RavinduHiroshan/MR_ROBOT/Mr.Robot.pdf

## MR. ROBOT

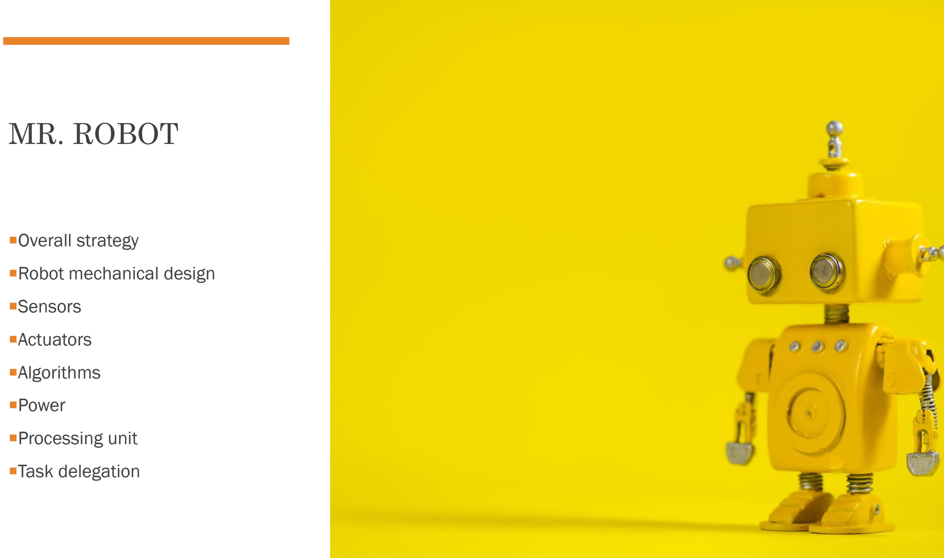
[picture p15: page 1]

Overall strategy

Robot mechanical design

Sensors

Actuators

Algorithms

Power

Processing unit

Task delegation

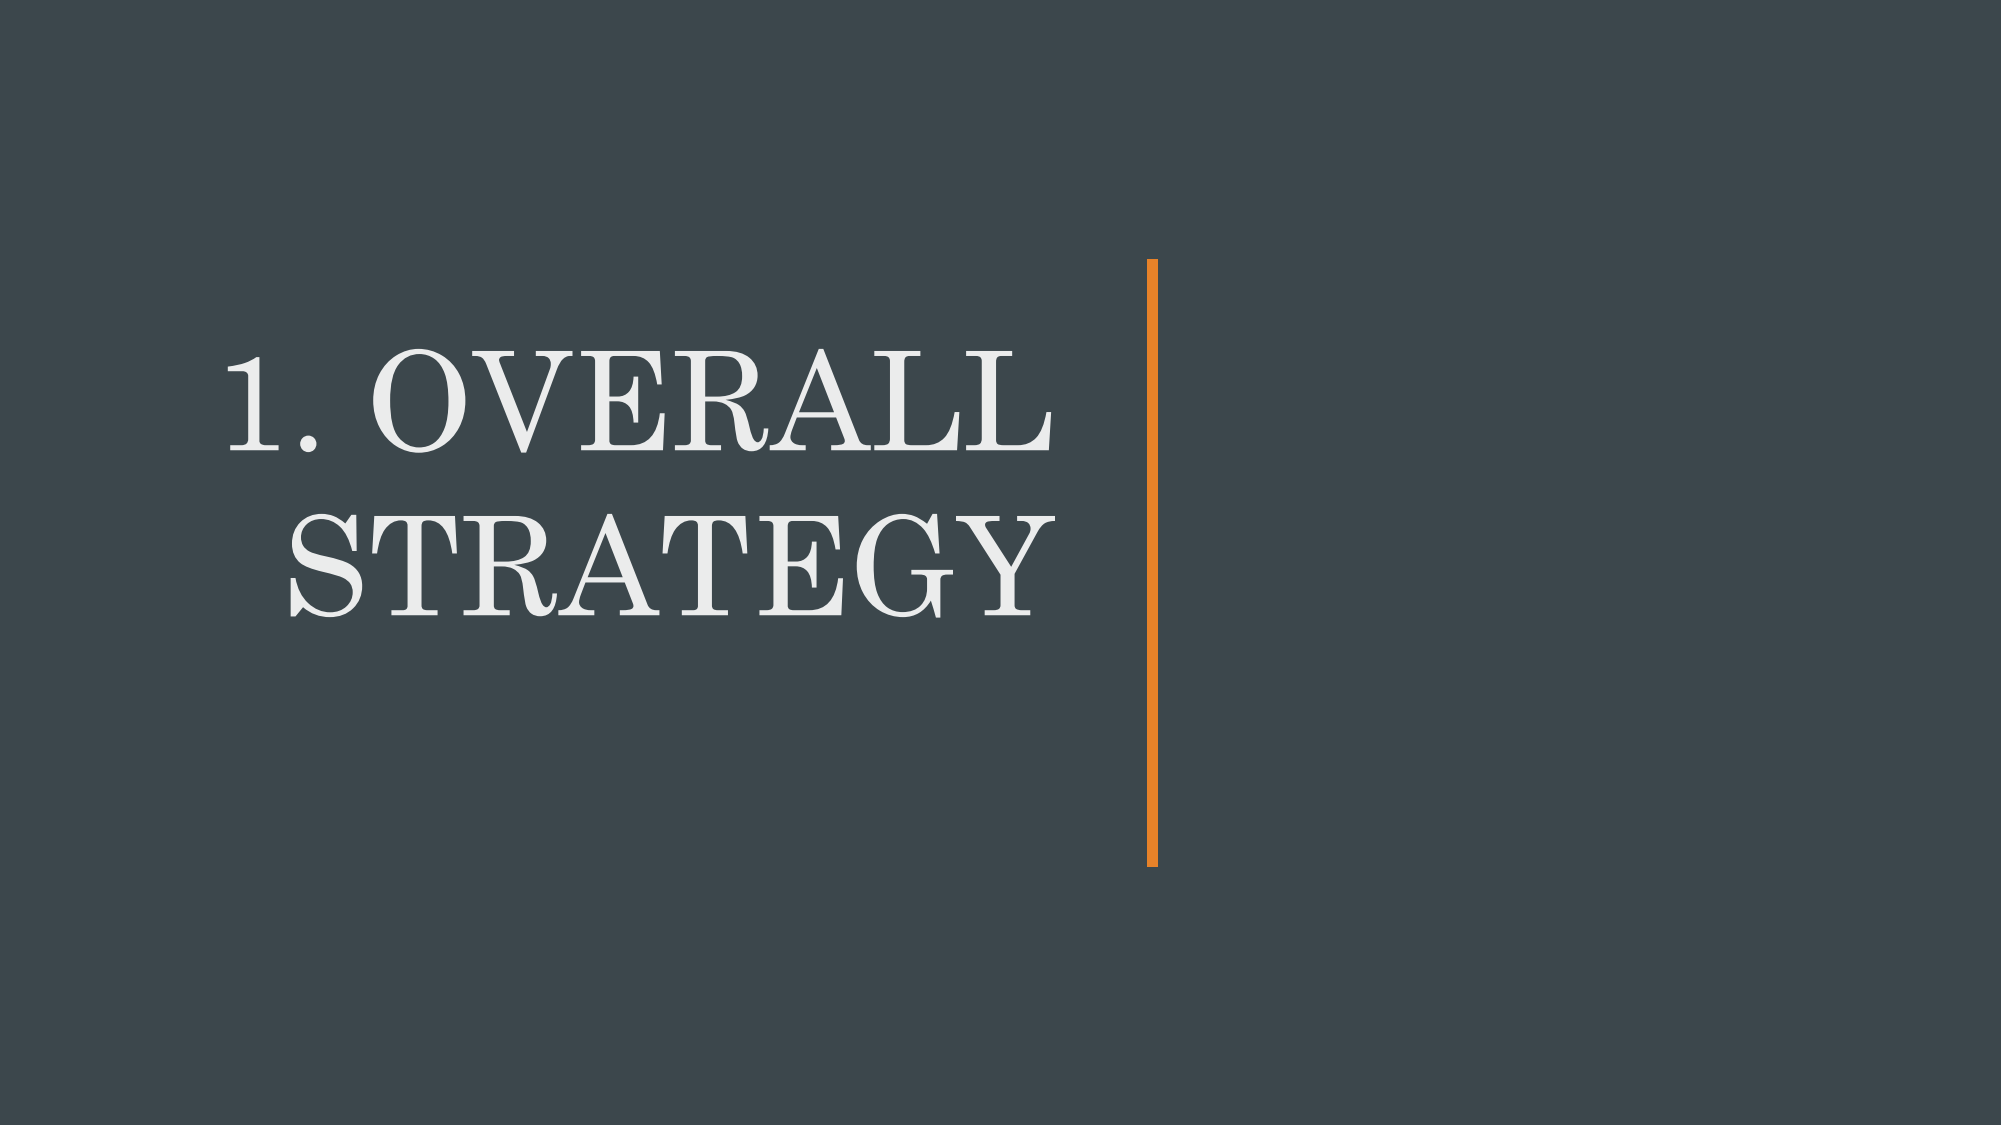
[picture p16: page 2]

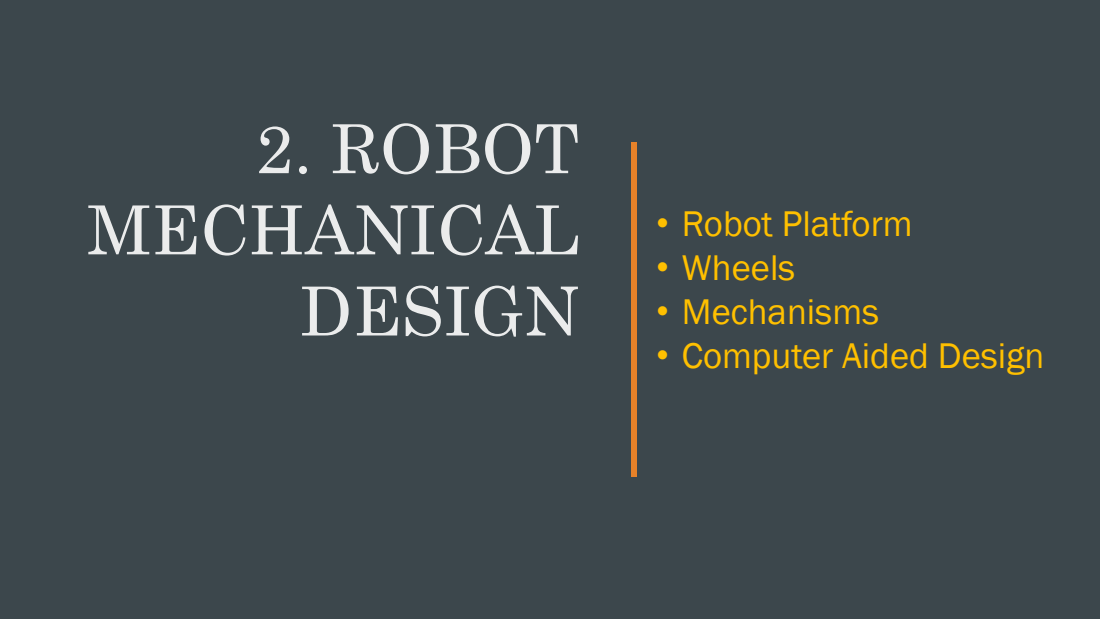
[picture p17: page 3]

• Robot Platform
• Wheels
• Mechanisms
• Computer Aided Design

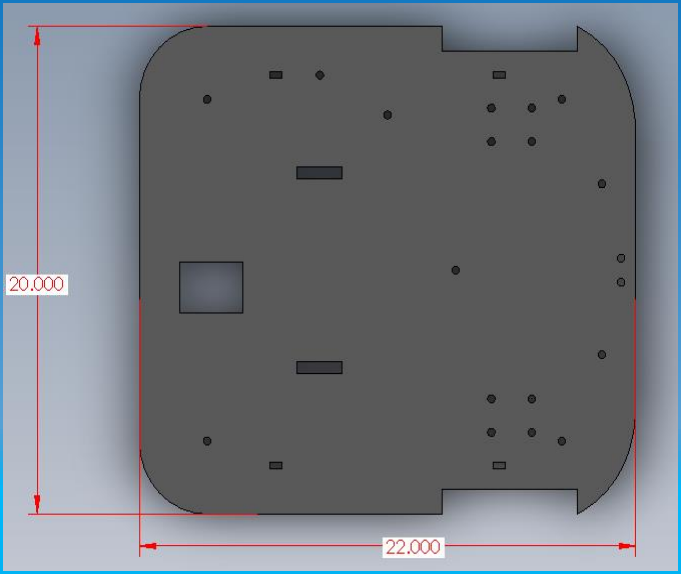
[picture p18: figure]

# BLUEPRINT

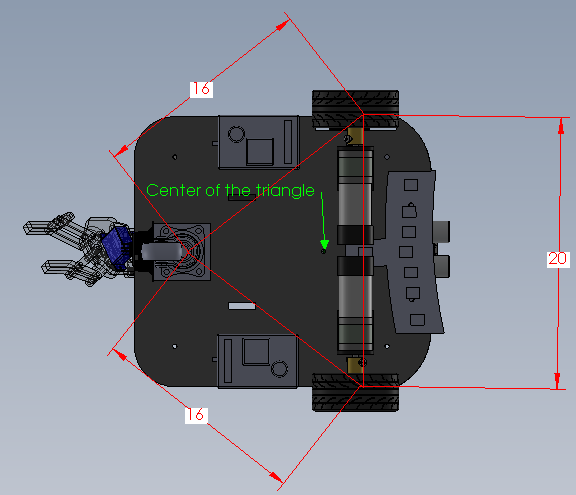
[picture p19: figure]

# SUPPORT POLYGON & WHEELS

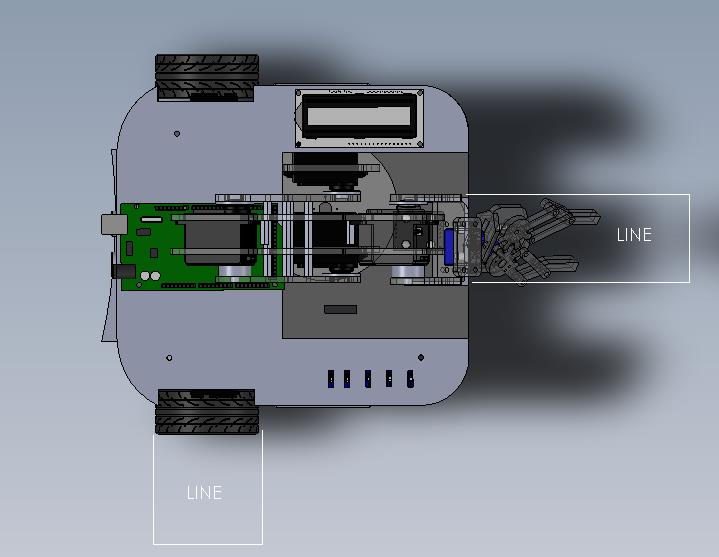
[picture p20: figure]

# DRIVE MECHANISM

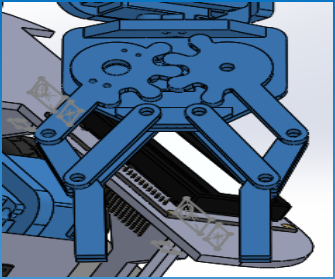
[picture p21: figure]

# ARM MECHANISM

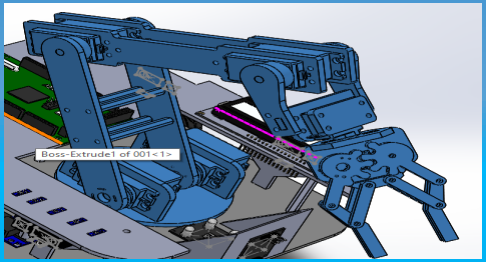
[picture p22: figure]

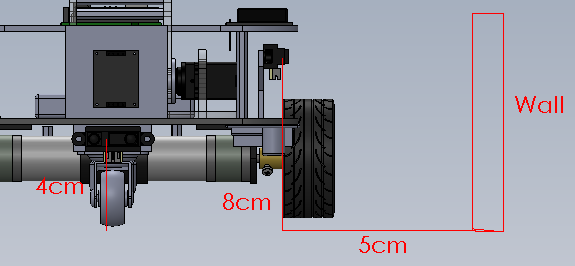
[picture p23: figure]

# SENSOR

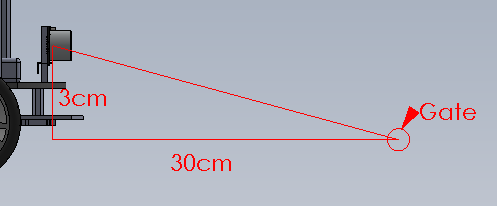
[picture p24: figure]

# PLACEMENT

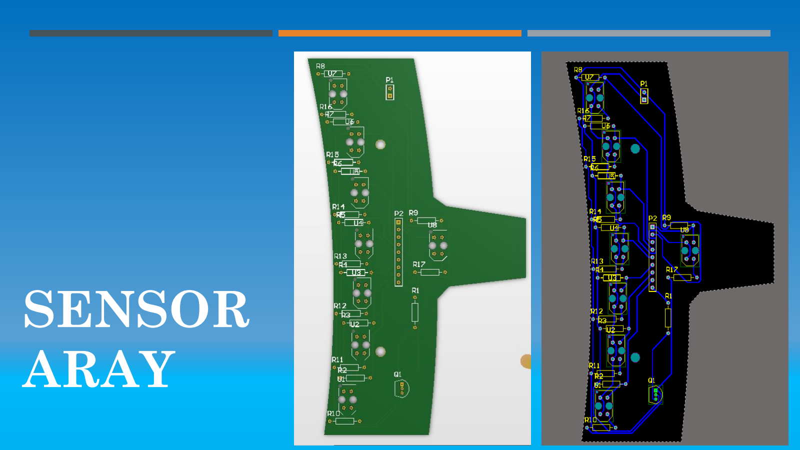
[picture p25: page 9]

# SENSOR ARAY

# COMPUTER AIDED DESIGN

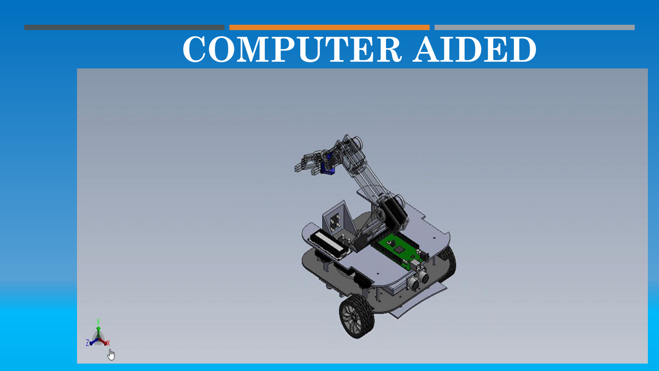
[picture p26: page 10]
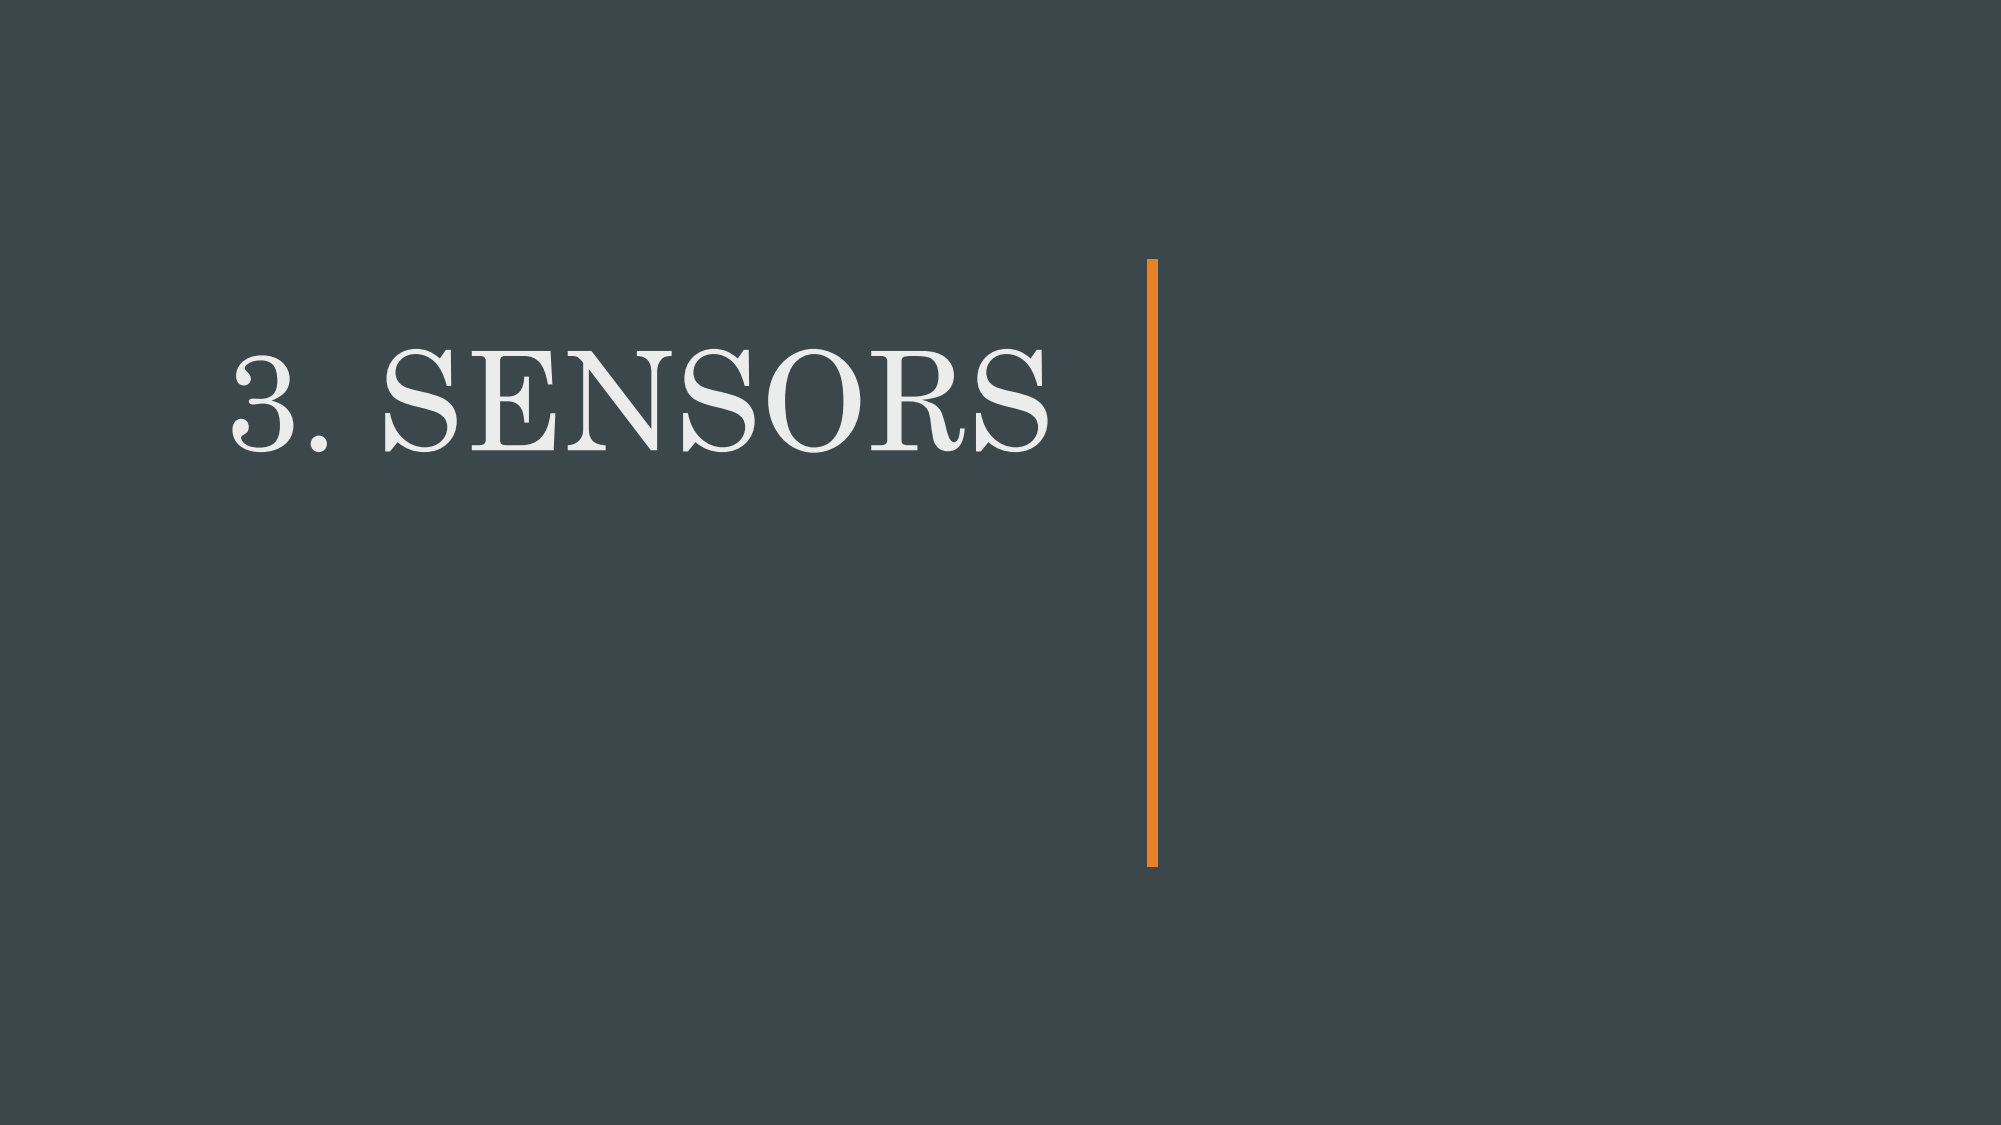
[picture p27: page 11]

# Sharp IR

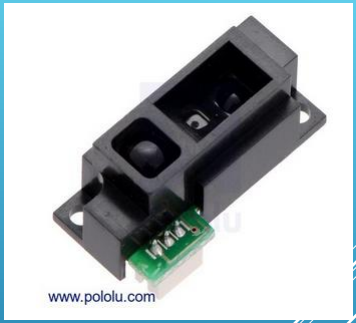
[picture p28: figure]

Name – GP2Y0A51
Detect range – 2cm to 15cm
Number of sensors we use – 5 sensors (GP2Y0A51) Located on- Left side 2, Right side 2 and Back side 1

we use the sharp IRs for
- Wall Following
- Pillars detecting
- Color box detecting

Why should we use that sharp IR GP2Y0A51?
- Wall is curve therefore difficult to identify using Ultrasonic sensors
- Wall and the pillars are 15cm away from the white line

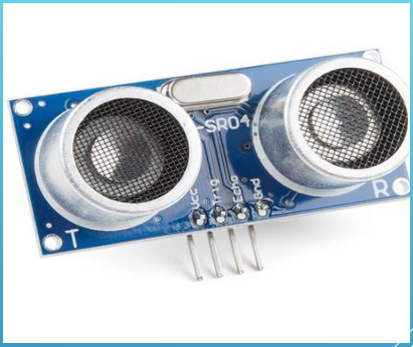
[picture p29: figure]

## Ultrasonic Sensor

Name – HC-SR04
In practically measuring distance range – 2cm to 80cm Measuring angle covered – 15 degrees covered Number of sensors we use – only one sensor
Located on – front side of the robot

## we use the ultrasonic sensor for

- We use to detect the synchronous gate

## Why should we use ultrasonic?

- It has 15 degrees measuring angle covered
- Gate is a moving object therefore we need a wider range sensor
- Before the gate we have a holding position. From holding position to gate has 30cm-40cm distance approximately

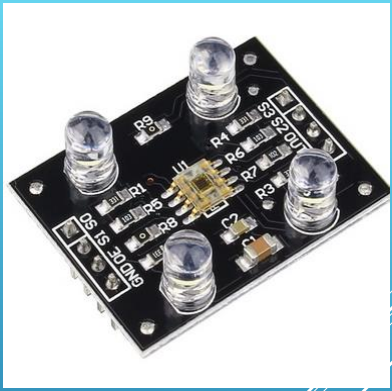
[picture p30: figure]

# Color sensor

Name – TCS230
8x8 photo diode array
Using current to frequency converter
Light measurements should be made at about 1~3cm to get a more accurate result.

Number of sensors we use – 2 sensors
Located on – design a special box for put the color box

Why should we use TCS230 sensors?
- In our task has 3 colors( red, blue, green)
- This sensor module can easy to identify red, blue and green
- frequency directly proportional to the light intensity
- Avarage cost

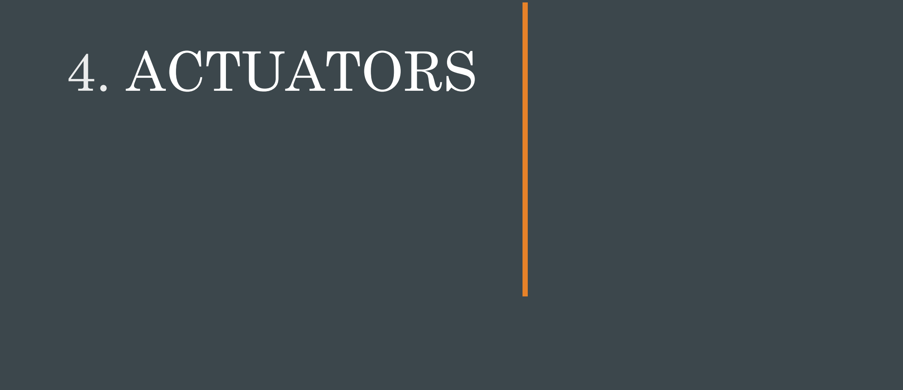
[picture p31: figure]
ACTUATORS

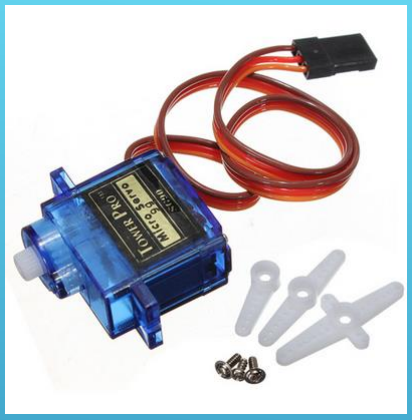
[picture p32: figure]

## Servo Motors

Name – MG90 and SG90
Number of servos – 6 servors ( 2 SG90 and 4 MG90 ) Using PWM system
| MG90 | SG90
Operating Voltage | 4.8V- 6V | 4.8V- 6V
Rotate | 180 degrees | 180 degrees
torque | 2.2 Kg/cm | 2.5Kg/cm
Gear type | Metal | Plastic

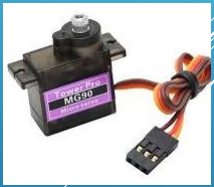
[picture p33: figure]

## Why should we use servo motors?

## 34:1 12V High Power DC Motor

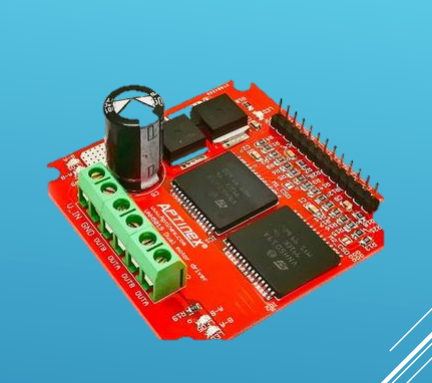
[picture p34: figure]
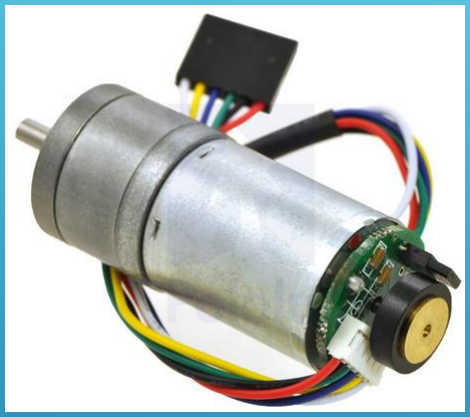
[picture p35: figure]

High Power Motor needs 5.6A stall current

We selected special motor drive
Dagaya 1.0
Maximum current -12A
Number of drives -2

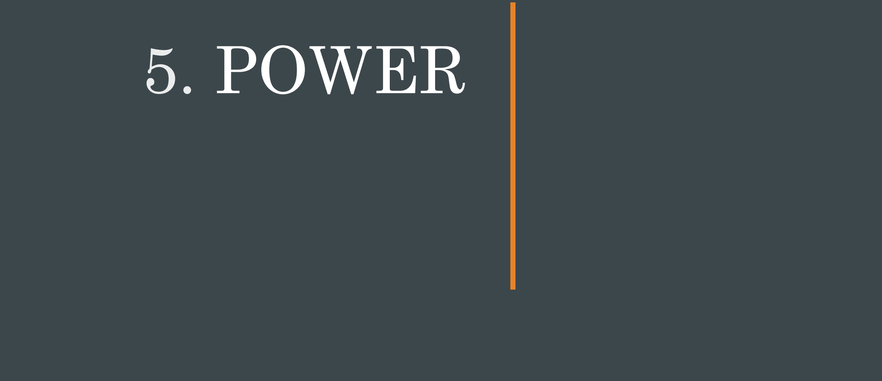
[picture p36: figure]
POWER

# Power System

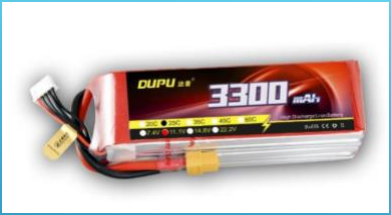
[picture p37: figure]

Name – Lithium Polymer Rechargeable battery 3300mAh
25C

## Why we use ?

We need – nearly 3000mA (maximum) Required discharge rate – 6C

# POWER

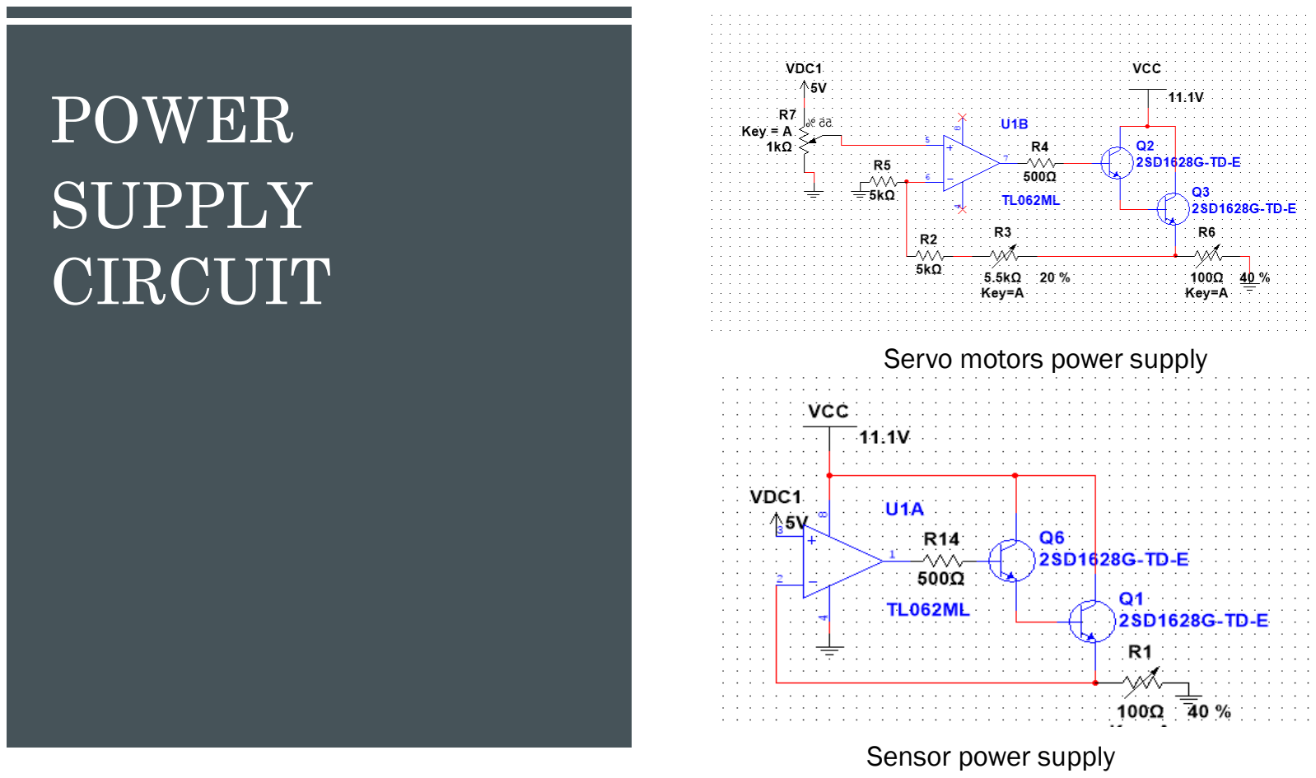
[picture p38: page 20]

# SUPPLY CIRCUIT

Sensor power supply

Servo motors power supply

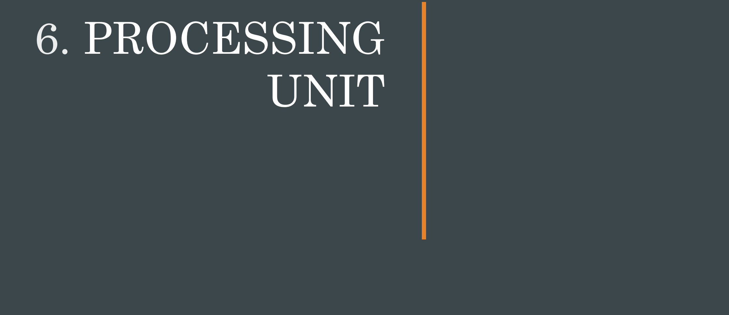
[picture p39: figure]
PROCESSING UNIT

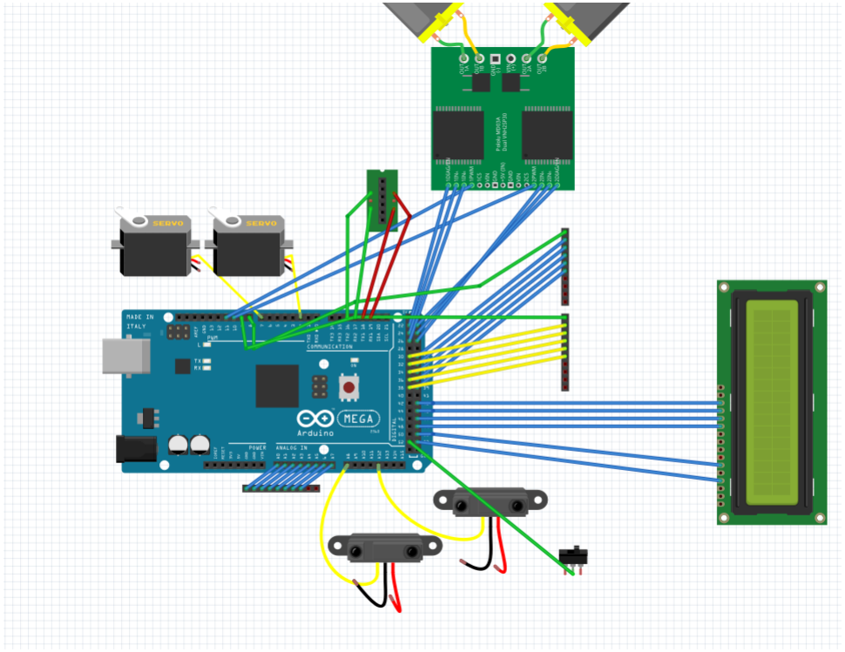
[picture p40: figure]

### - Arduino Mega 2560

### Board Is used as

### processing unit

### - Image shows wire

### configuration of the

### Arduino borard

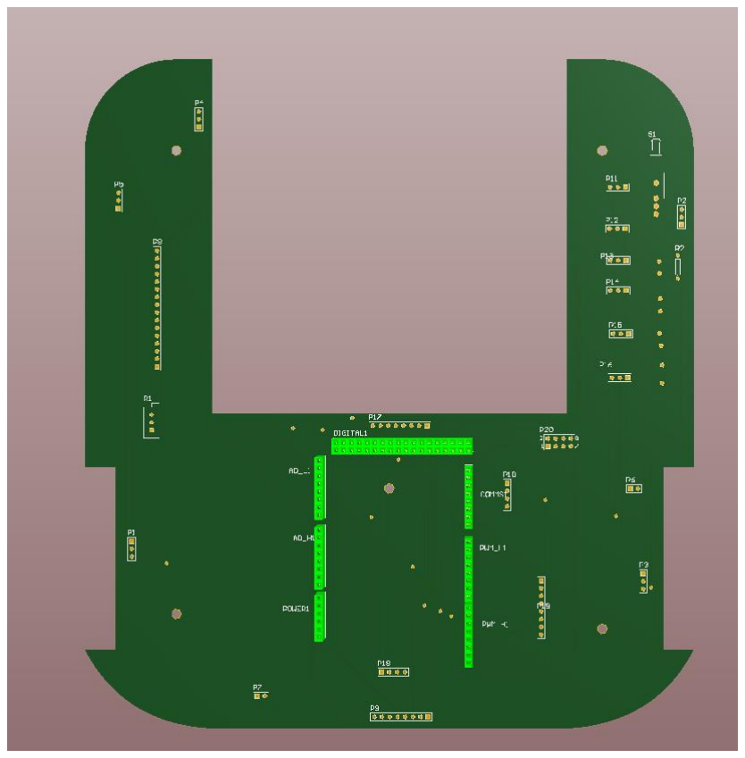
[picture p41: figure]

# PCB DESIGNS

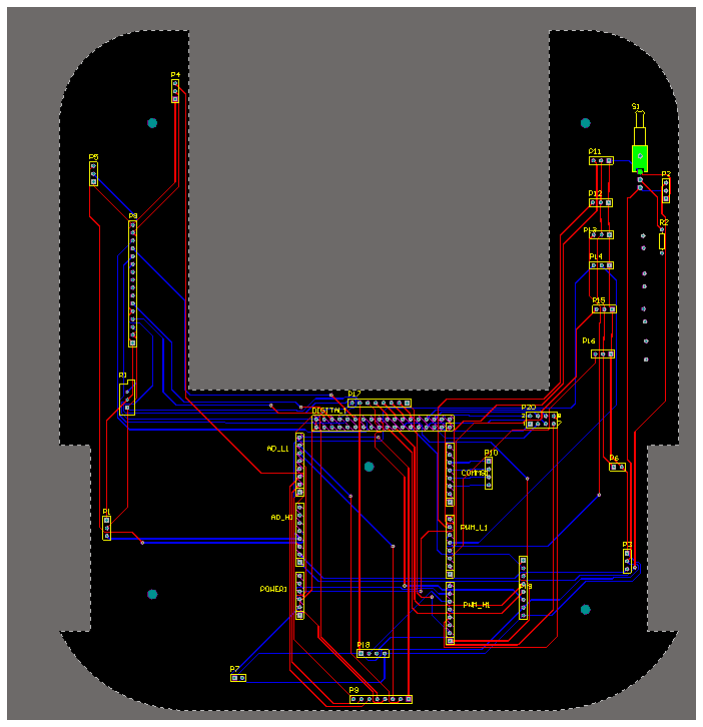
[picture p42: figure]
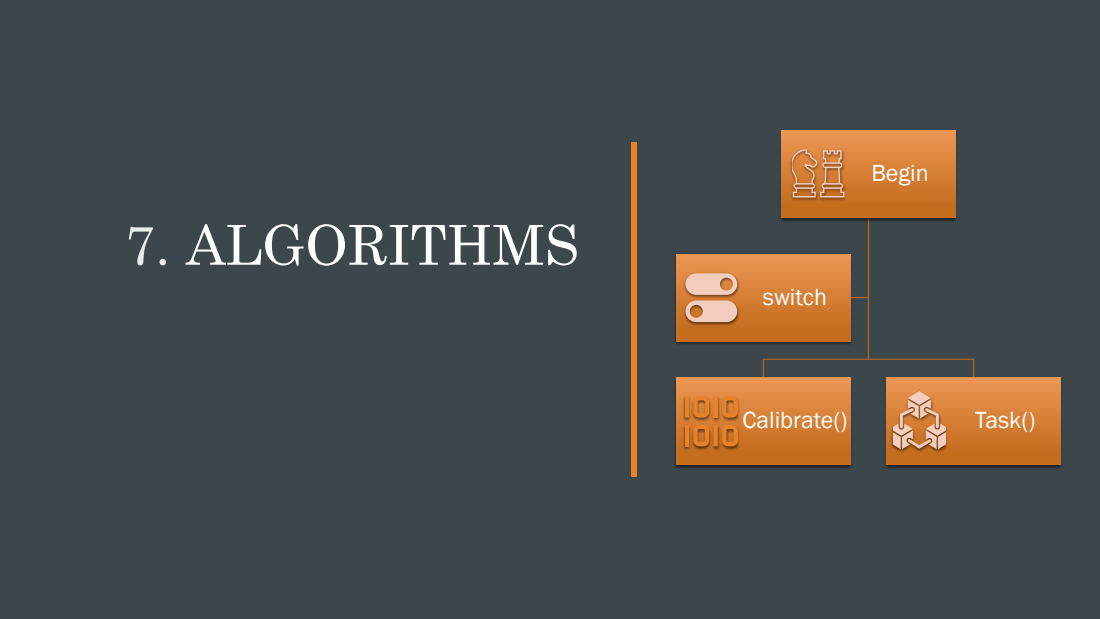
[picture p43: page 24]
ALGORITHMS; Begin; Calibrate(); Task(); switch

# Stages

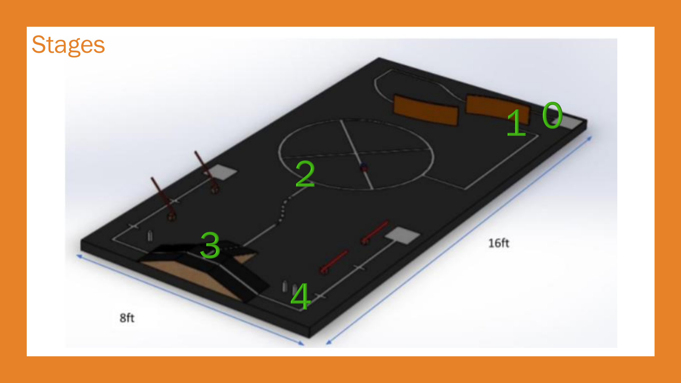
[picture p44: page 25]

### Calibrate()

1. Get maximum values of each sensors

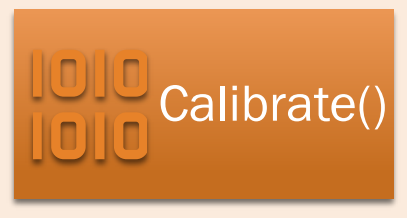
[picture p45: figure]
Calibrate()

2. Get minimum values of each sensors
3. Calculate average maximum
4. Calculate average minimum
5. Th (Thresher hold) = (average maximum + average minimum)/2
6. Return Th

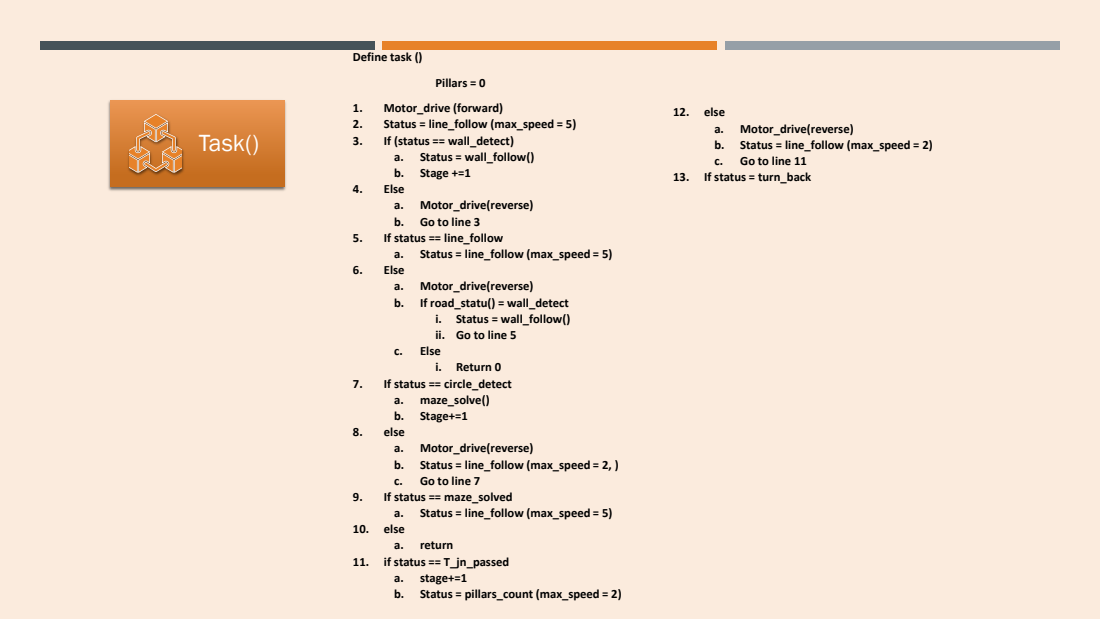
[picture p46: page 27]
Define task (); Pillars = 0; 1. Motor_drive (forward) 2. Status = line_follow (max_speed = 5) 3. If (status == wall_detect) a. Status = wall_follow() b. Stage +=1 4. Else; 5. If status == line_follow a. Status = line_follow (max_speed = 5) 6. Else a. Motor_drive(reverse) b. If road_statu() = wall_detect; c. Else i. Return 0 7. If status == circle_detect a. maze_solve() b. Stage+=1 8. else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

a. Motor_drive(reverse)
b. Status = line_follow (max_speed = 2)
c. Go to line 11

b. Go to line 3

i. Status = wall_follow()
ii. Go to line 5

b. Status = line_follow (max_speed = 2, )
c. Go to line 7

# SUB ALGORITHMS

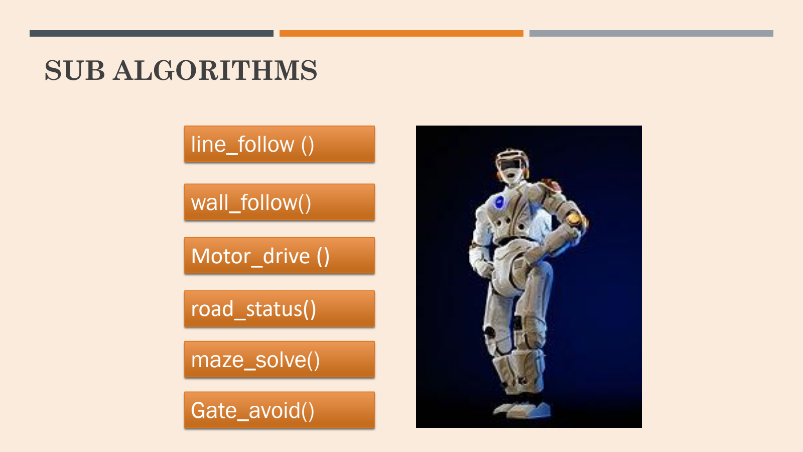
[picture p47: page 28]

## Motor_drive ()

## road_status()

## Gate_avoid()

## wall_follow()

## maze_solve()

## line_follow ()

# Sub Task

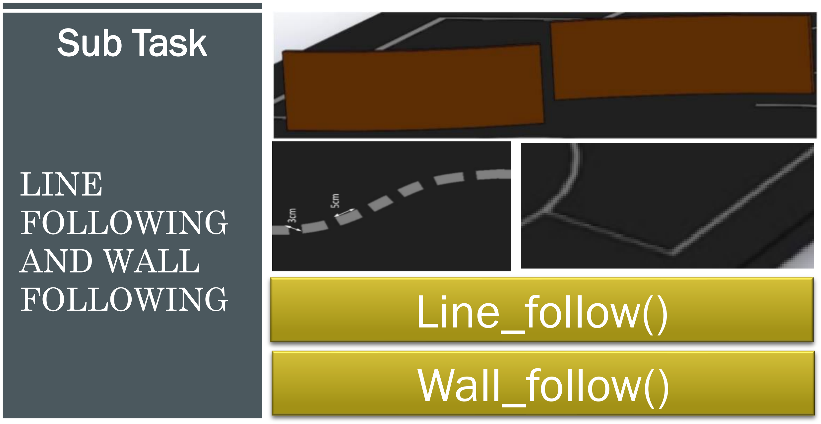
[picture p48: page 29]

# LINE FOLLOWING AND WALL

FOLLOWING | Line_follow()
| Wall_follow()

# Sub Task

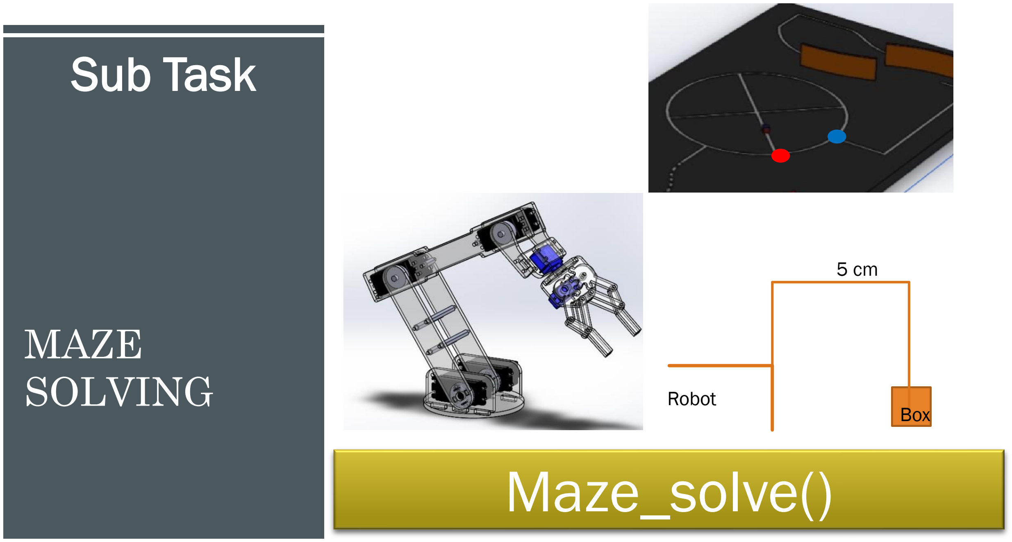
[picture p49: page 30]

# MAZE SOLVING

# Maze_solve()

5 cm

Box

Robot

# Sub Task

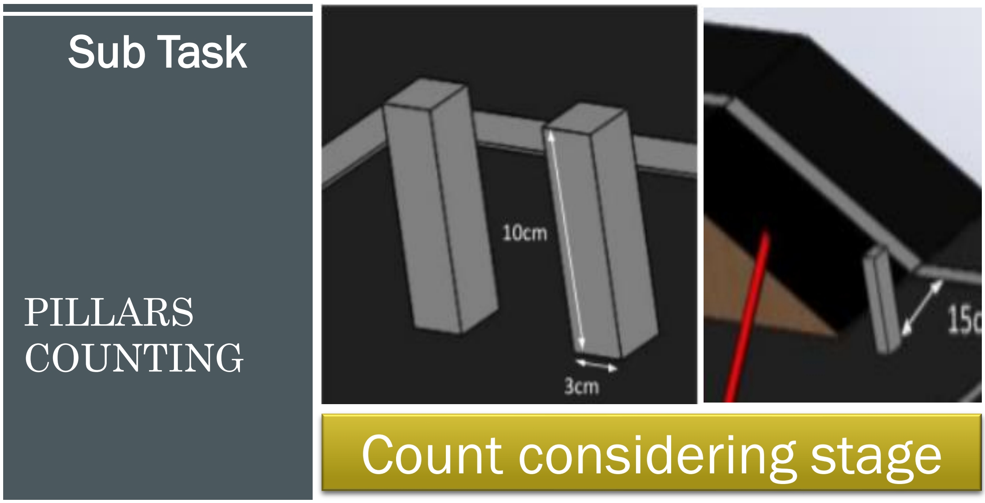
[picture p50: page 32]

# PILLARS COUNTING

# Count considering stage

# Sub Task

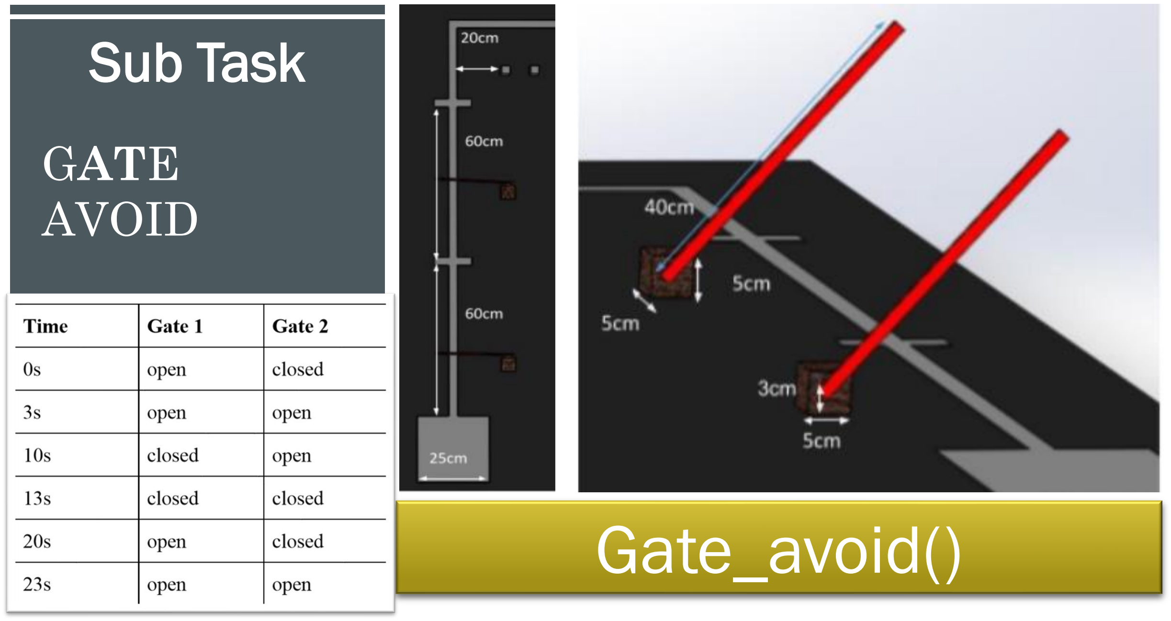
[picture p51: page 33]

# GATE AVOID

# Gate_avoid()

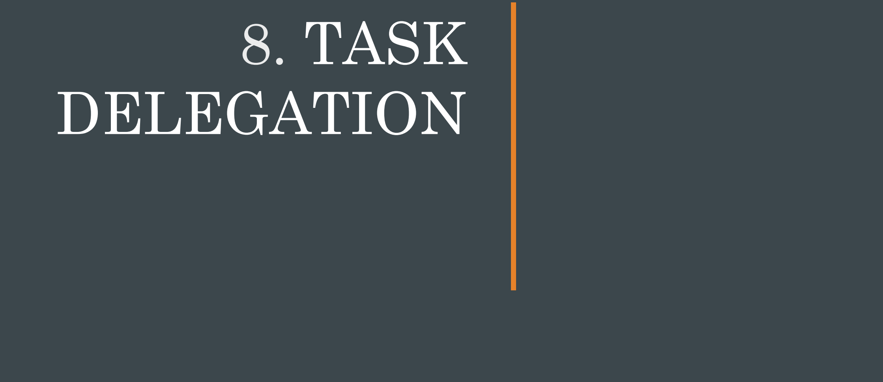
[picture p52: figure]
TASK DELEGATION

Allocated Works | Team members
Hardware design | SIRITHUNGA M.R.A. JAYAWEERA D.S.B.C.L. ARIYARATHNE H.D.M.P.
PCB design & Circuitry | KANNANGARA D.N. JAYAWEERA D.S.B.C.L. HIROSHAN H.H.R.
Algorithm | ARIYARATHNE H.D.M.P. KANNANGARA D.N. SIRITHUNGA M.R.A.
Stage 0 of the task | HIROSHAN H.H.R.
Stage 1 of the task | KANNANGARA D.N.
Stage 2 of the task | SIRITHUNGA M.R.A.
Stage 3 of the task | JAYAWEERA D.S.B.C.L.
Stage 4 of the task | ARIYARATHNE H.D.M.P.

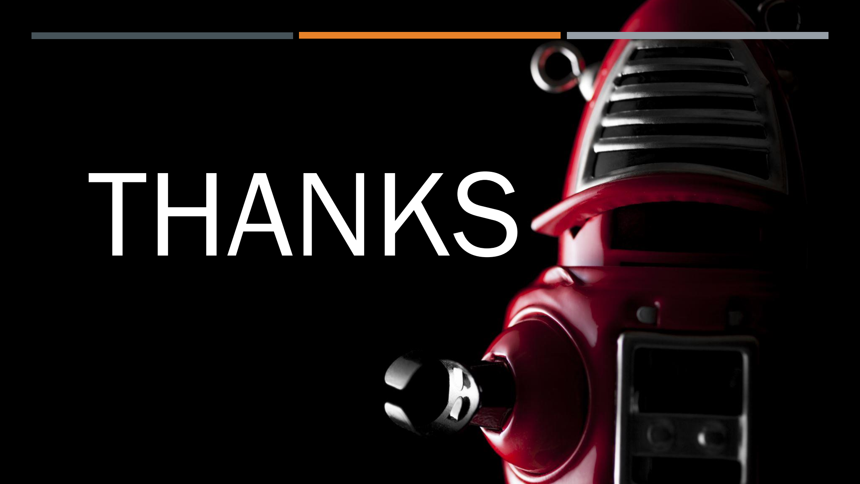
[picture p53: page 36]

# THANKS

## Submitted by

KANNANGARA D.N. | 180301A
SIRITHUNGA M.R.A. | 180609B
ARIYARATHNE H.D.M.P. | 180045P
JAYAWEERA D.S.B.C.L. | 180288L
HIROSHAN H.H.R. | 180245E
