RavinduHiroshan/MR_ROBOT/EN2532_Arena_v4_1/EN2532_Arena_v4_1/worlds/samplearena3.stl

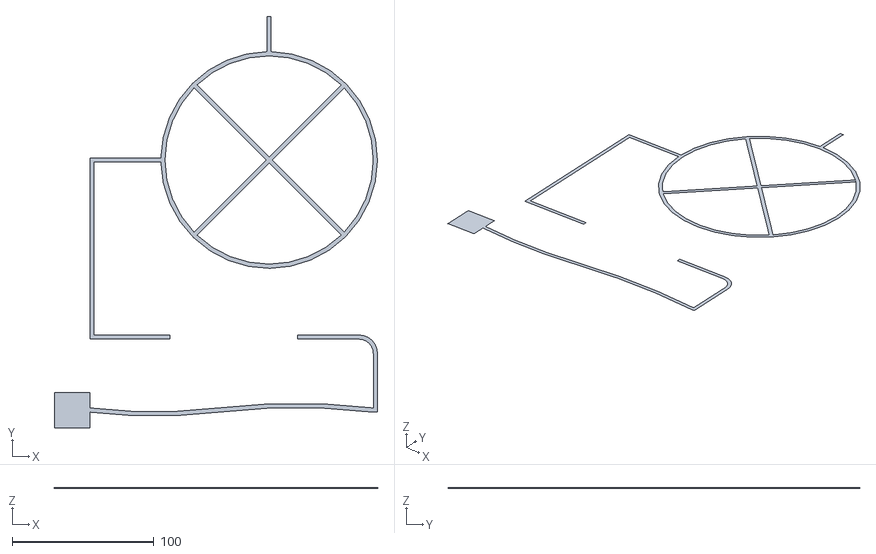
[picture p54: CAD file, 2021-07-05]
EN2532_Arena_v4_1/EN2532_Arena_v4_1/worlds/samplearena3.stl
228.0 x 290.5 x 0.01
