RavinduHiroshan/MR_ROBOT/Webots_STL/Scaled_Ramp.STL

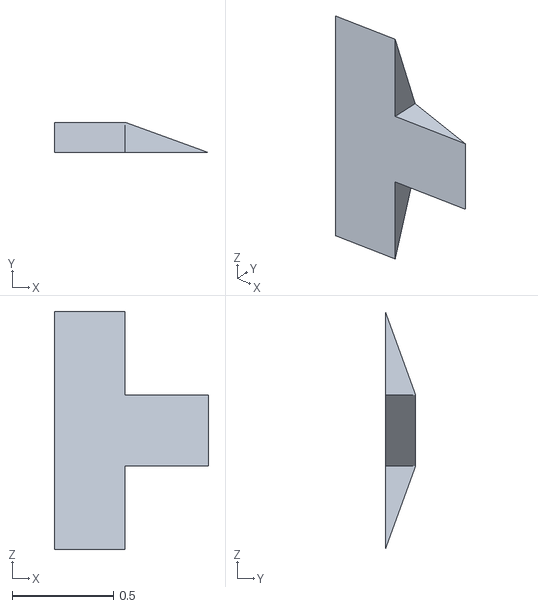
[picture p55: CAD file, 2021-07-22]
Webots_STL/Scaled_Ramp.STL
0.762 x 0.15 x 1.17
