RavinduHiroshan/MR_ROBOT/EN2532_Arena_v4_1/EN2532_Arena_v4_1/worlds/wall1.stl

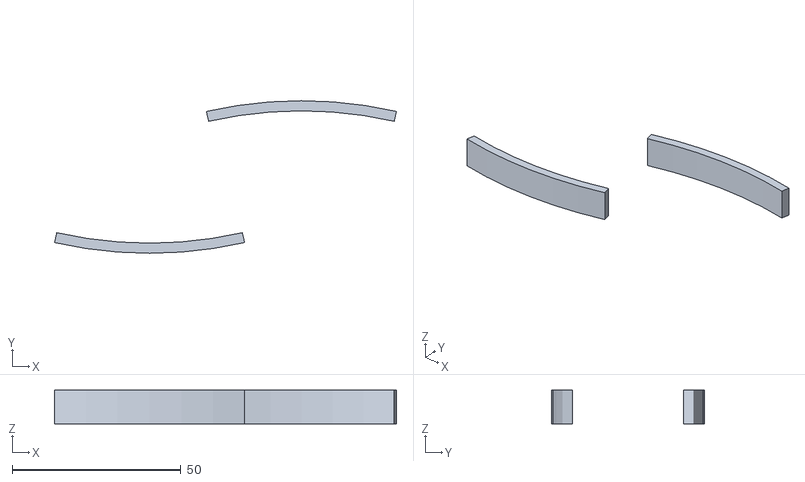
[picture p56: CAD file, 2021-07-05]
EN2532_Arena_v4_1/EN2532_Arena_v4_1/worlds/wall1.stl
101.3 x 45.2 x 10.00
