RavinduHiroshan/MR_ROBOT/Webots_STL/scaled_two_crosses.STL

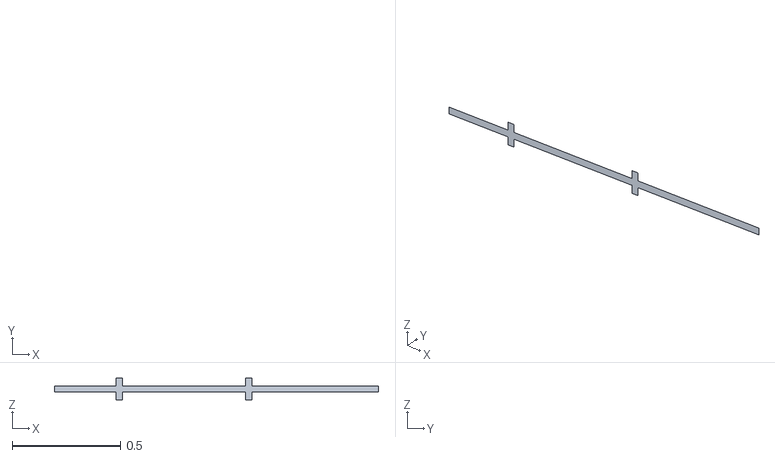
[picture p57: CAD file, 2021-07-22]
Webots_STL/scaled_two_crosses.STL
1.50 x 0 x 0.1
