RavinduHiroshan/MR_ROBOT/Webots_STL/scaled_two_crosses_final.STL

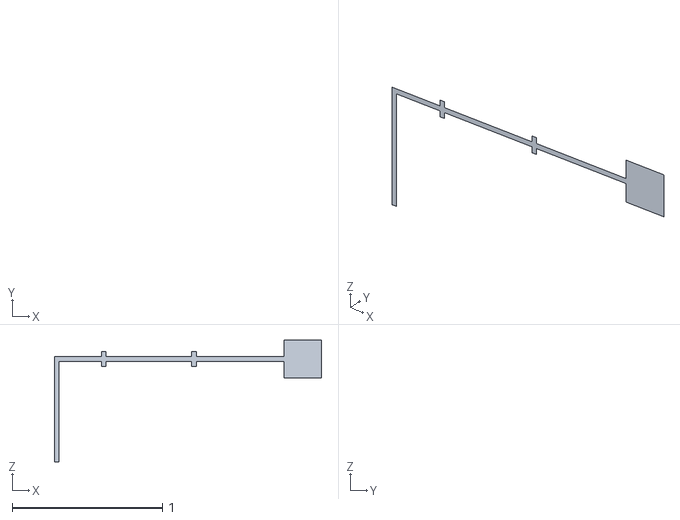
[picture p58: CAD file, 2021-07-22]
Webots_STL/scaled_two_crosses_final.STL
1.78 x 0 x 0.81
