RavinduHiroshan/MR_ROBOT/Webots_STL/scaled_dashed_line.STL

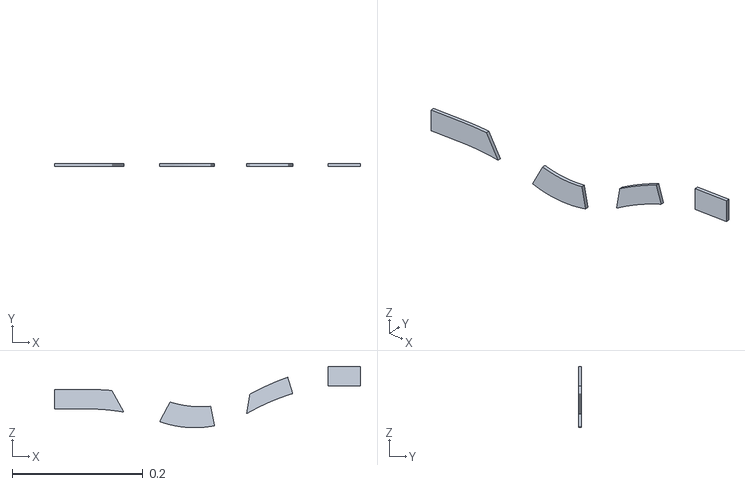
[picture p59: CAD file, 2021-07-22]
Webots_STL/scaled_dashed_line.STL
0.469 x 0.005 x 0.0941
