RavinduHiroshan/MR_ROBOT/Webots_STL/Scaled_Ramp_T.STL

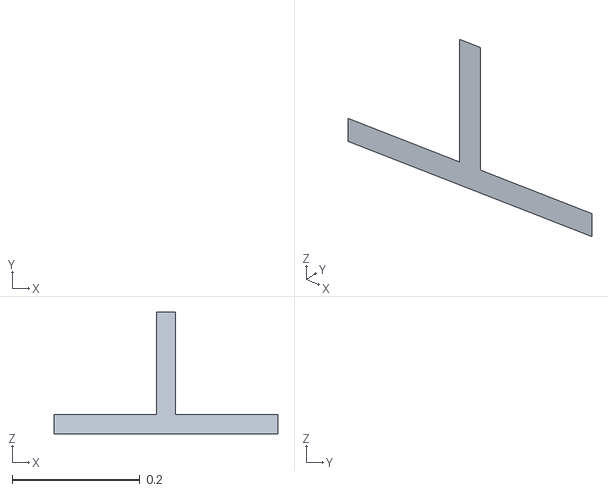
[picture p60: CAD file, 2021-07-22]
Webots_STL/Scaled_Ramp_T.STL
0.35 x 1e-06 x 0.19
