RavinduHiroshan/MR_ROBOT/Webots_STL/scaled_ramp_slope.STL

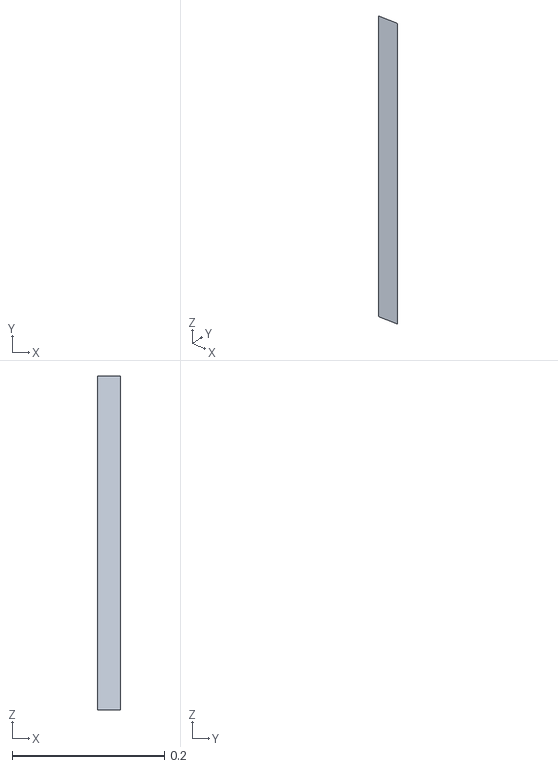
[picture p61: CAD file, 2021-07-22]
Webots_STL/scaled_ramp_slope.STL
0.03 x 1e-06 x 0.439
