RavinduHiroshan/MR_ROBOT/Webots_STL/scaled_two_crosses2.STL

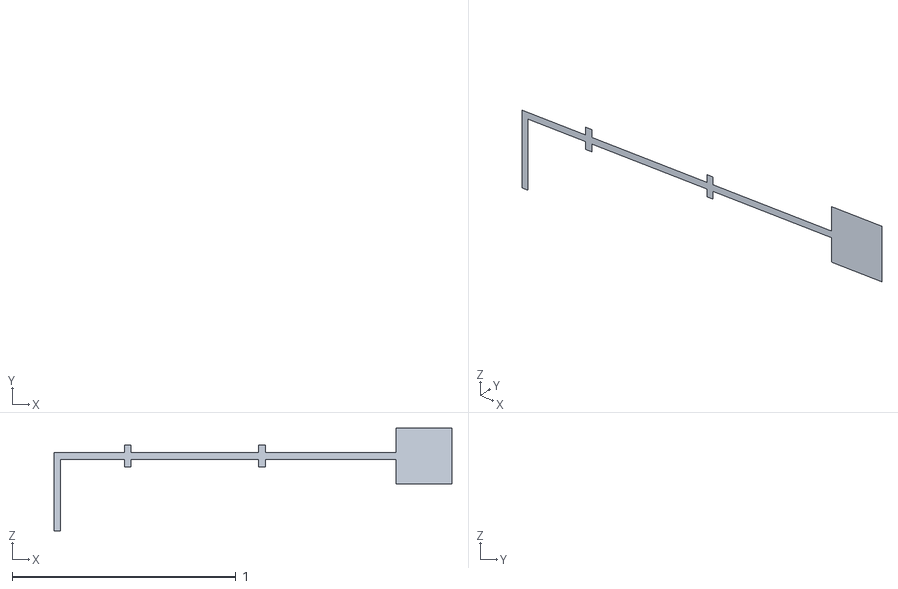
[picture p62: CAD file, 2021-07-22]
Webots_STL/scaled_two_crosses2.STL
1.78 x 0 x 0.46
