RavinduHiroshan/MR_ROBOT/Webots_STL/arm.SLDPRT

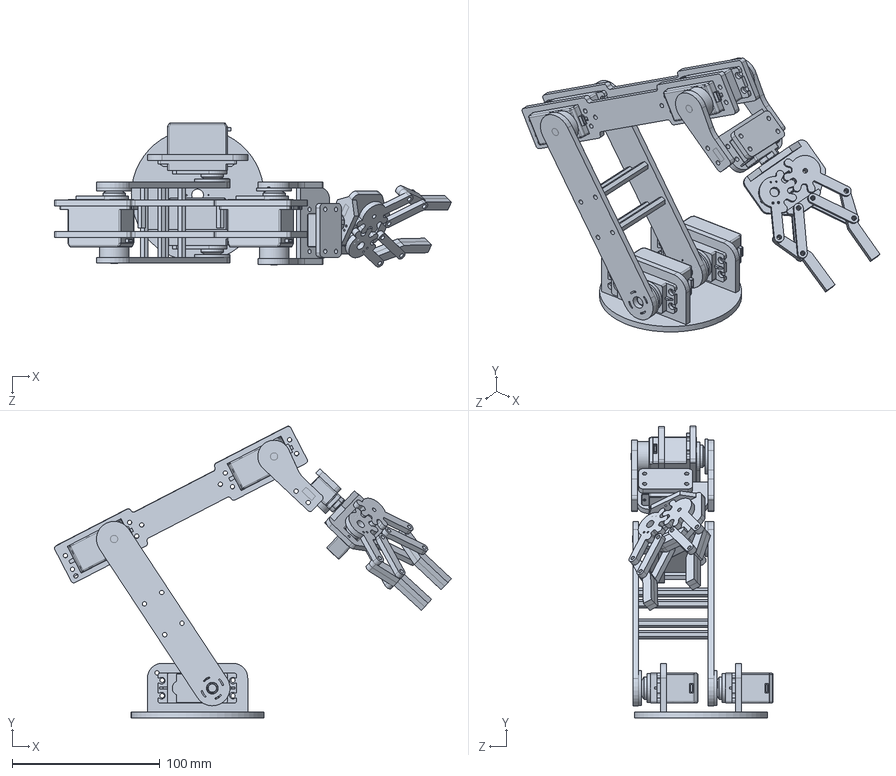
[picture p63: CAD file, 2021-07-05]
Webots_STL/arm.SLDPRT
269.1 x 197.7 x 97.8 mm
