RavinduHiroshan/MR_ROBOT/Webots_STL/Scaled_Hiroshan_robot.STL

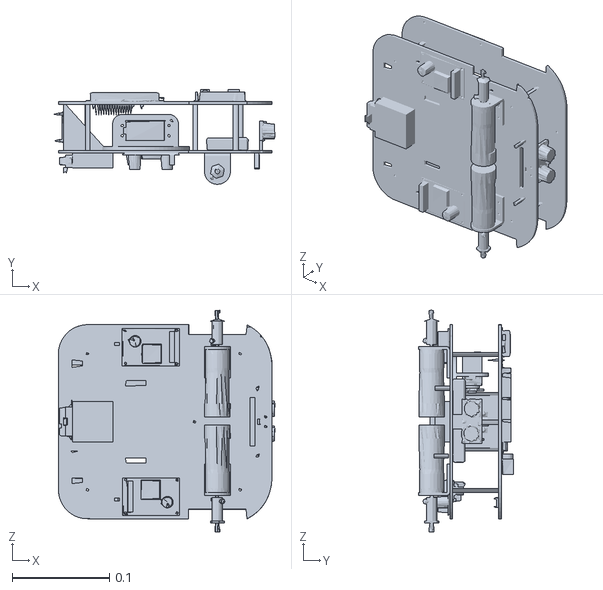
[picture p64: CAD file, 2021-07-05]
Webots_STL/Scaled_Hiroshan_robot.STL
0.228 x 0.0976 x 0.229
