RavinduHiroshan/MR_ROBOT/Webots_STL/Scaled_Box.STL

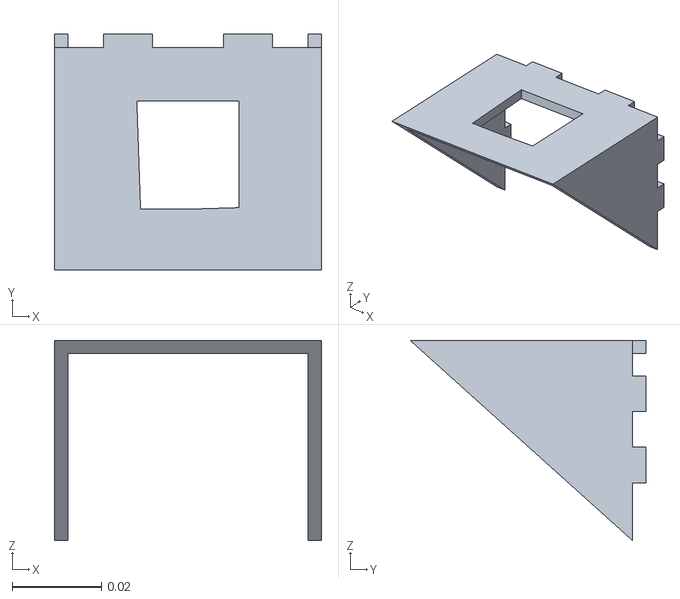
[picture p65: CAD file, 2021-07-05]
Webots_STL/Scaled_Box.STL
0.06 x 0.053 x 0.045
