RavinduHiroshan/MR_ROBOT/Webots_STL/scaled_part1_robotarm.STL

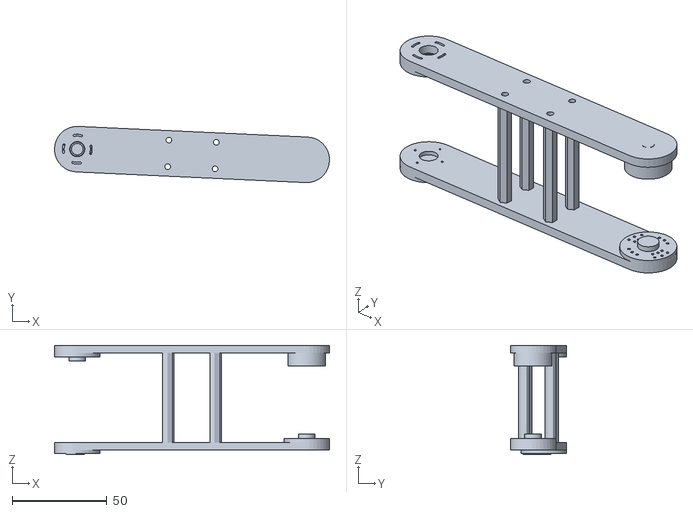
[picture p66: CAD file, 2021-07-05]
Webots_STL/scaled_part1_robotarm.STL
144.8 x 29.6 x 57.6
