RavinduHiroshan/MR_ROBOT/Webots_STL/scaled_servo arm part 1.SLDPRT

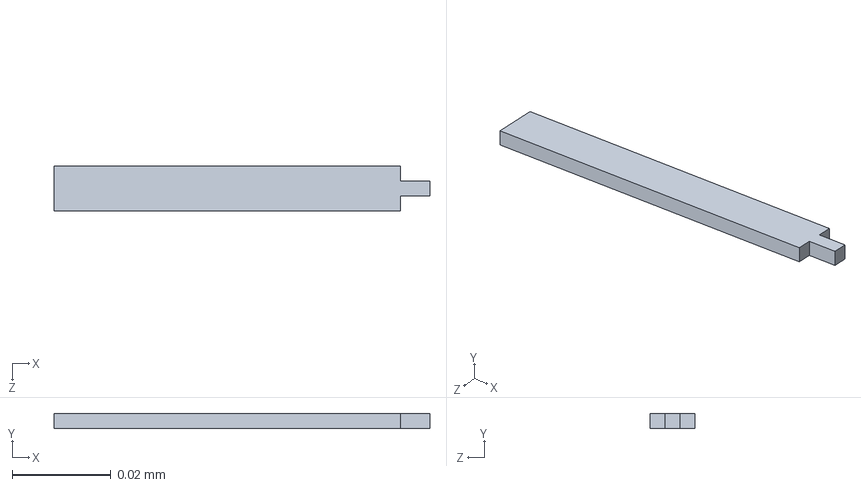
[picture p67: CAD file, 2021-07-05]
Webots_STL/scaled_servo arm part 1.SLDPRT
0.076 x 0.003 x 0.009 mm
