RavinduHiroshan/MR_ROBOT/Webots_STL/Scaled_part2_ robotarm.STL

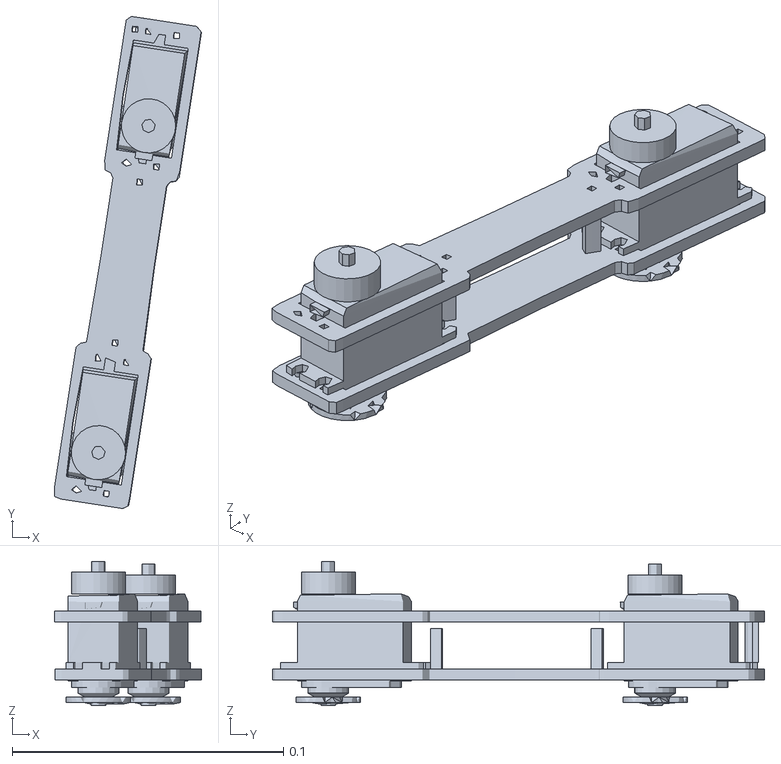
[picture p68: CAD file, 2021-07-05]
Webots_STL/Scaled_part2_ robotarm.STL
0.0542 x 0.182 x 0.0533
