RavinduHiroshan/MR_ROBOT/Webots_STL/scaled_tooth_robotarm.STL

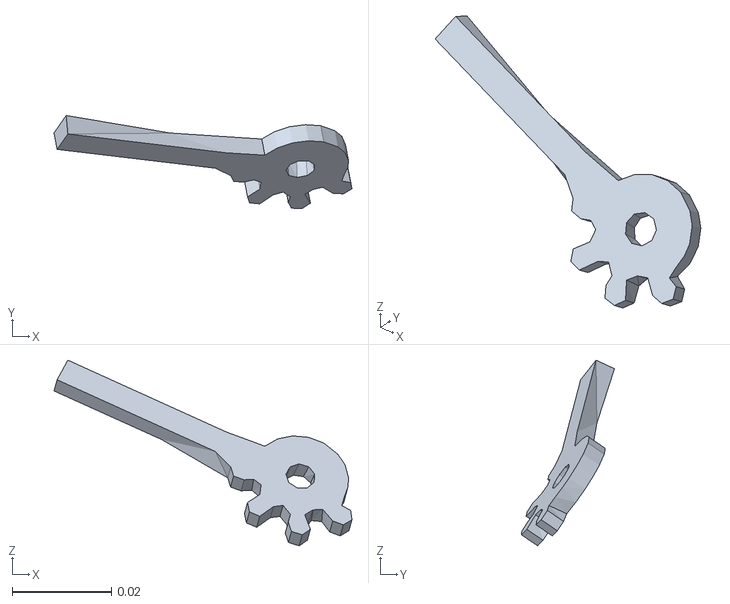
[picture p69: CAD file, 2021-07-05]
Webots_STL/scaled_tooth_robotarm.STL
0.0602 x 0.0188 x 0.0375
