RavinduHiroshan/MR_ROBOT/Webots_STL/scaled+part4_robotarm.STL

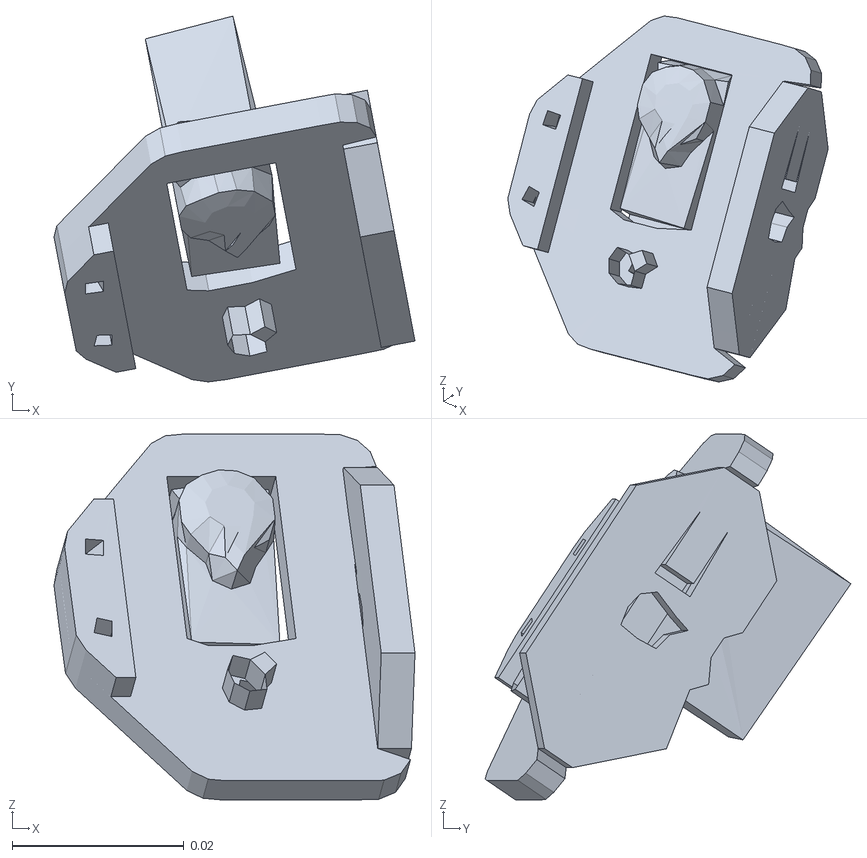
[picture p70: CAD file, 2021-07-05]
Webots_STL/scaled+part4_robotarm.STL
0.042 x 0.0426 x 0.0425
