RavinduHiroshan/MR_ROBOT/Webots_STL/arm_2.SLDPRT

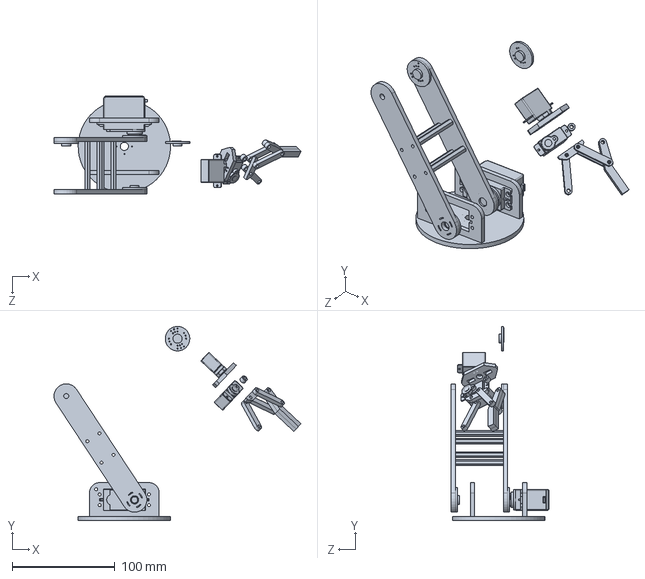
[picture p71: CAD file, 2021-07-05]
Webots_STL/arm_2.SLDPRT
240.6 x 189.1 x 95.1 mm
