RavinduHiroshan/MR_ROBOT/Webots_STL/arm_3.SLDPRT

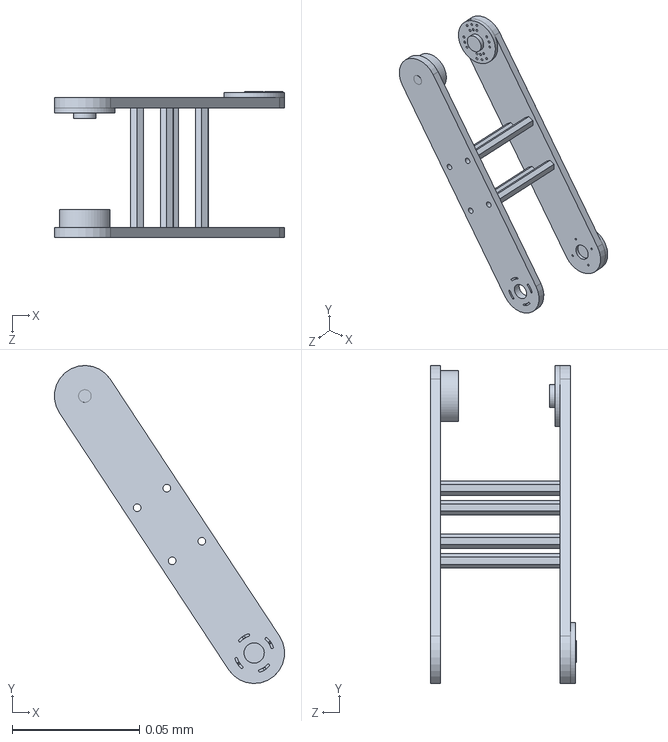
[picture p72: CAD file, 2021-07-05]
Webots_STL/arm_3.SLDPRT
0.0904 x 0.125 x 0.0576 mm
