RavinduHiroshan/MR_ROBOT/Webots_STL/Scaled_part3_robotarm.STL

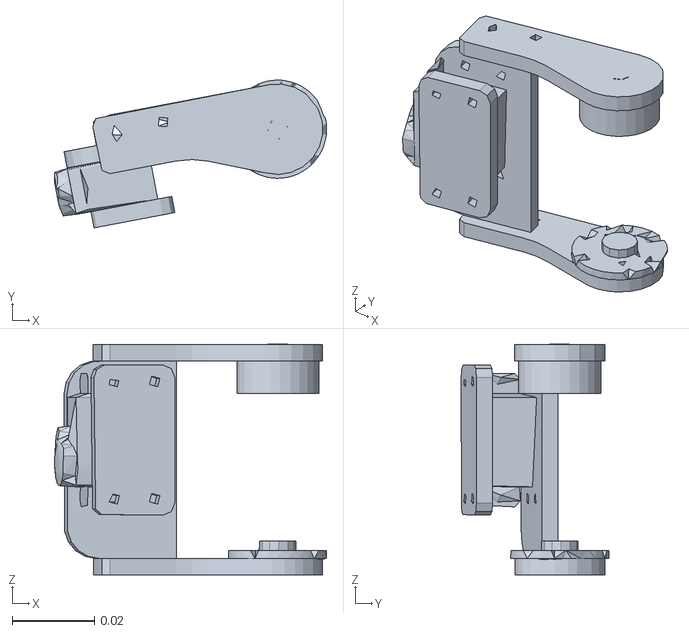
[picture p73: CAD file, 2021-07-05]
Webots_STL/Scaled_part3_robotarm.STL
0.0661 x 0.0359 x 0.0561
