RavinduHiroshan/MR_ROBOT/Webots_STL/Scaled_rack.SLDPRT

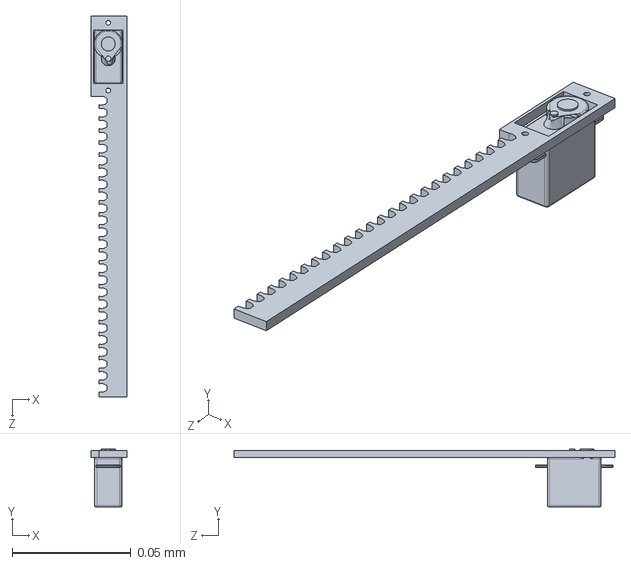
[picture p74: CAD file, 2021-06-25]
Webots_STL/Scaled_rack.SLDPRT
0.015 x 0.0244 x 0.16 mm
