RavinduHiroshan/MR_ROBOT/Webots_STL/Scaled_platform.SLDPRT

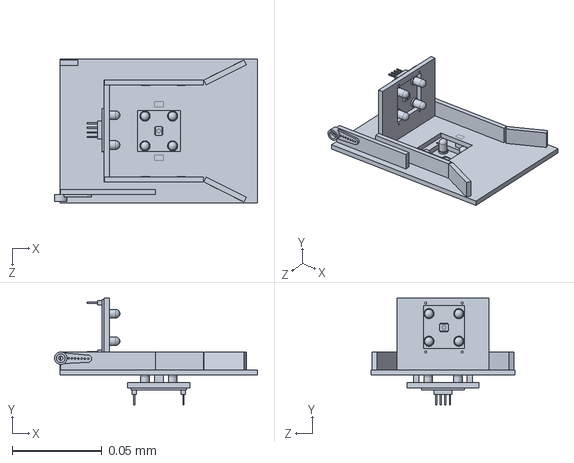
[picture p75: CAD file, 2021-06-25]
Webots_STL/Scaled_platform.SLDPRT
0.113 x 0.0595 x 0.08 mm
