RavinduHiroshan/MR_ROBOT/Webots_STL/Scaled_bound.SLDPRT

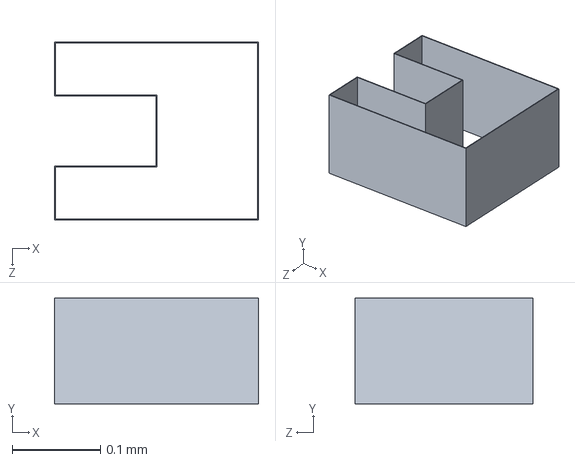
[picture p76: CAD file, 2021-06-25]
Webots_STL/Scaled_bound.SLDPRT
0.231 x 0.12 x 0.201 mm
