RavinduHiroshan/MR_ROBOT/Webots_STL/Scaled_Caster_Wheel_Arduino.SLDPRT

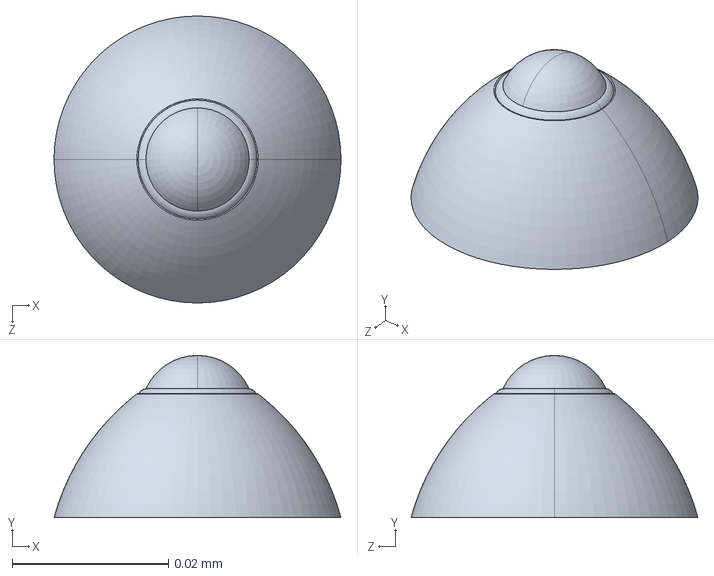
[picture p77: CAD file, 2021-06-25]
Webots_STL/Scaled_Caster_Wheel_Arduino.SLDPRT
0.0367 x 0.0207 x 0.0367 mm
