RavinduHiroshan/MR_ROBOT/Webots_STL/Scaled_servoarm1.SLDPRT

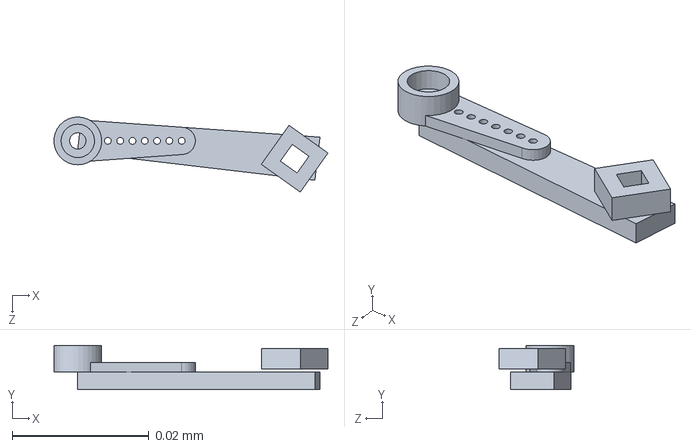
[picture p78: CAD file, 2021-06-25]
Webots_STL/Scaled_servoarm1.SLDPRT
0.0401 x 0.00644 x 0.011 mm
