RavinduHiroshan/MR_ROBOT/Webots_STL/Scaled_Tyre.SLDPRT

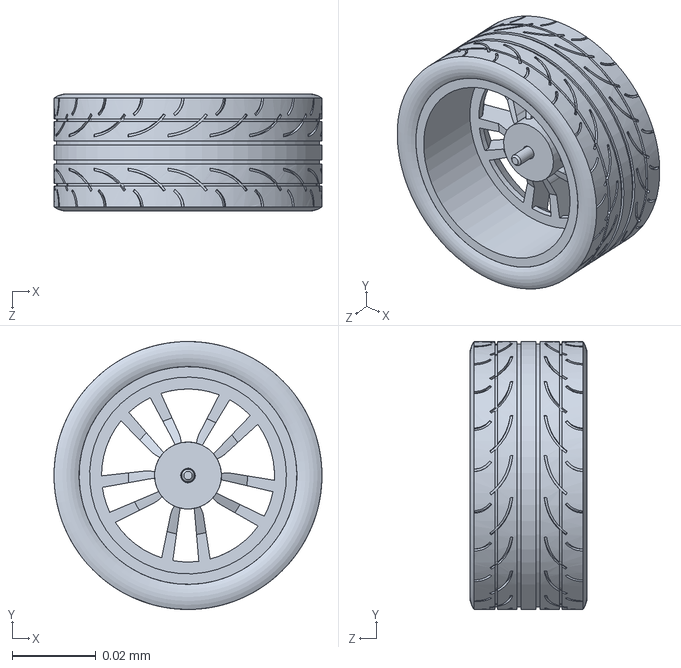
[picture p79: CAD file, 2021-06-25]
Webots_STL/Scaled_Tyre.SLDPRT
0.064 x 0.064 x 0.028 mm
