RavinduHiroshan/MR_ROBOT/Webots_STL/Scaled_robot_webots.STL

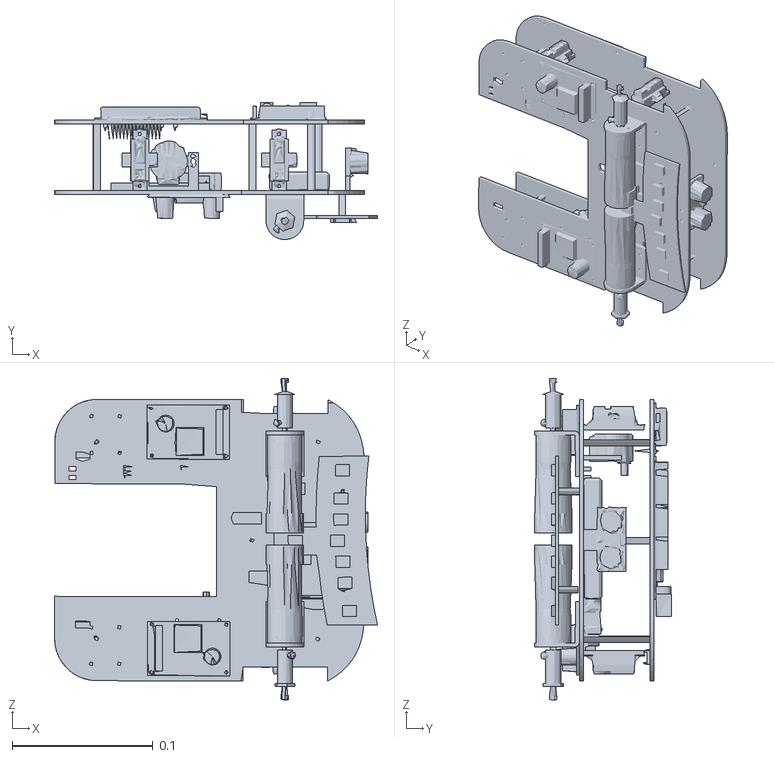
[picture p80: CAD file, 2021-06-25]
Webots_STL/Scaled_robot_webots.STL
0.23 x 0.0976 x 0.229
