RavinduHiroshan/MR_ROBOT/(list of files, cad)

Other CAD files:
Webots_STL/ARM.STL
Webots_STL/Scaled_Caster_Wheel_Arduino.STL
Webots_STL/Scaled_Hiroshan_robot (1).STL
Webots_STL/Scaled_Hiroshan_robot (2).STL
Webots_STL/Scaled_Tyre.STL
Webots_STL/Scaled_bound.STL
Webots_STL/Scaled_platform.STL
Webots_STL/Scaled_rack.STL
Webots_STL/Scaled_servoarm1.STL
Webots_STL/scaled_servo arm part 1 (1).STL
Webots_STL/scaled_servo arm part 1.STL
