RavinduHiroshan/MR_ROBOT/controllers/robotMain/lineFollowing.h

#ifndef lineFollowing_H    // To make sure you don't declare the function more than once by including the header multiple times.
#define lineFollowing_H  
void ReadGroudSensors();
void LineFollowingModule();
#endif
