RavinduHiroshan/MR_ROBOT/(commit log)

2021-06-27 Asiri's important changes( add platform and rack, adjust wheels)
2021-07-05 Arm Mechanism changed
    [ARM.STL, Scaled_Box.STL, Scaled_Hiroshan_robot (1).STL, Scaled_Hiroshan_robot (2).STL, Scaled_Hiroshan_robot.STL, Scaled_part2_ robotarm.STL, Scaled_part3_robotarm.STL, arm.SLDPRT]
